bdash/kicad-components/3D Models/Molex_Micro-Fit_3.0_43045-0810_2x04-1MP_P3.00mm_Horizontal.stp

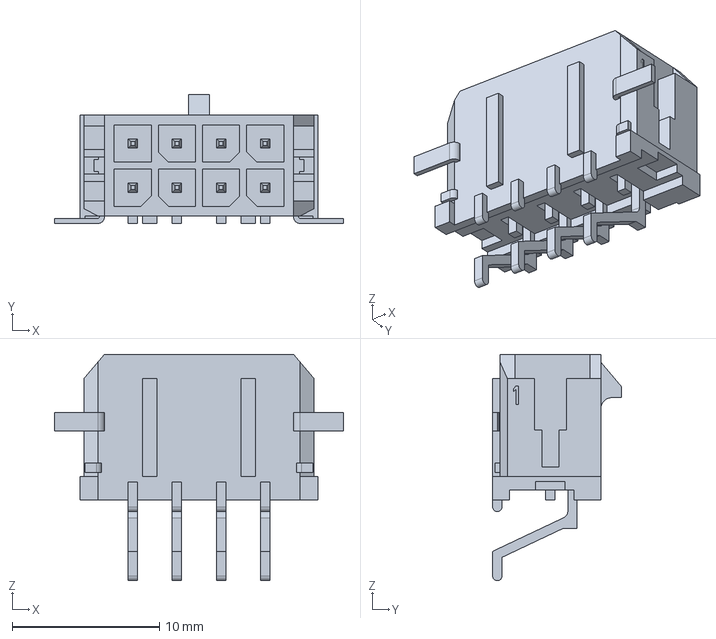
[picture p1: CAD file, 2024-04-28]
3D Models/Molex_Micro-Fit_3.0_43045-0810_2x04-1MP_P3.00mm_Horizontal.stp
19.6 x 8.77 x 15.4 mm
