bdash/kicad-components/3D Models/Molex_Micro-Fit_3.0_43045-1210_2x06-1MP_P3.00mm_Horizontal.stp

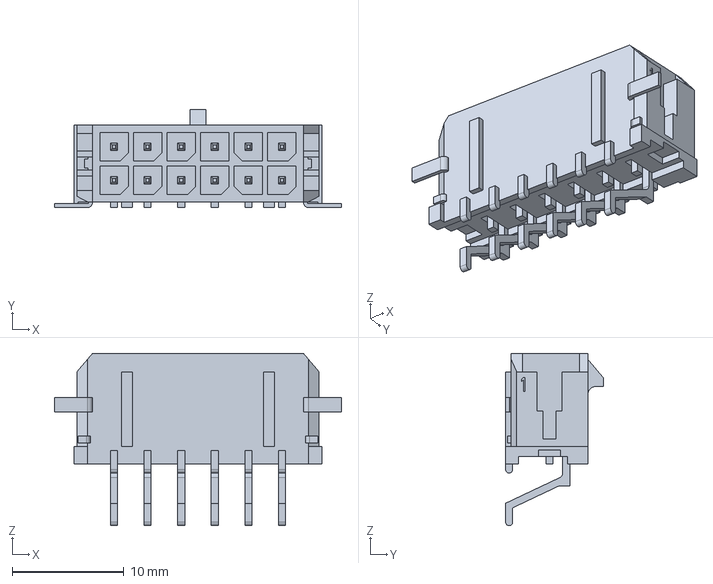
[picture p2: CAD file, 2024-04-28]
3D Models/Molex_Micro-Fit_3.0_43045-1210_2x06-1MP_P3.00mm_Horizontal.stp
25.6 x 8.77 x 15.4 mm
