bdash/kicad-components/3D Models/Molex_Micro-Fit_3.0_43650-0812_1x08-1MP_P3.00mm_Horizontal_PnP.stp

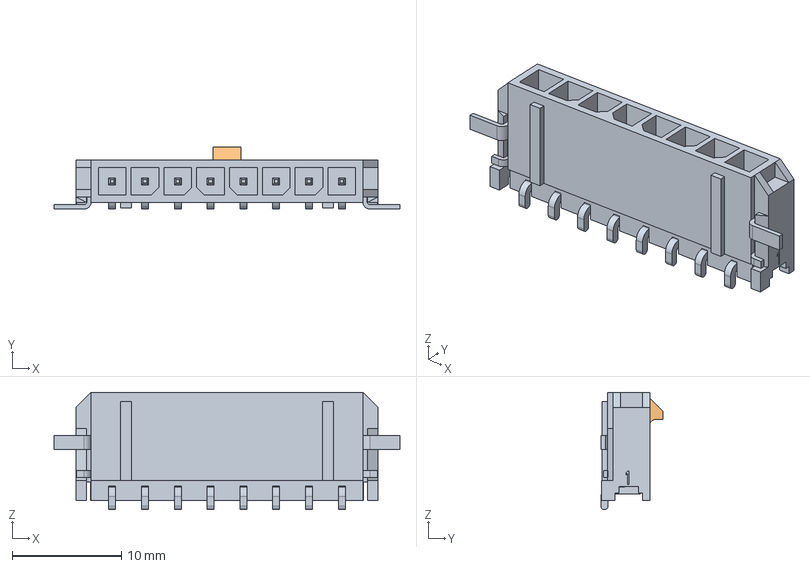
[picture p5: CAD file, 2024-04-14]
3D Models/Molex_Micro-Fit_3.0_43650-0812_1x08-1MP_P3.00mm_Horizontal_PnP.stp
31.6 x 5.67 x 10.7 mm
