bdash/kicad-components/3D Models/JST_PA_SM12B-PASS_1x12-1MP_P2.00mm_Horizontal.stp

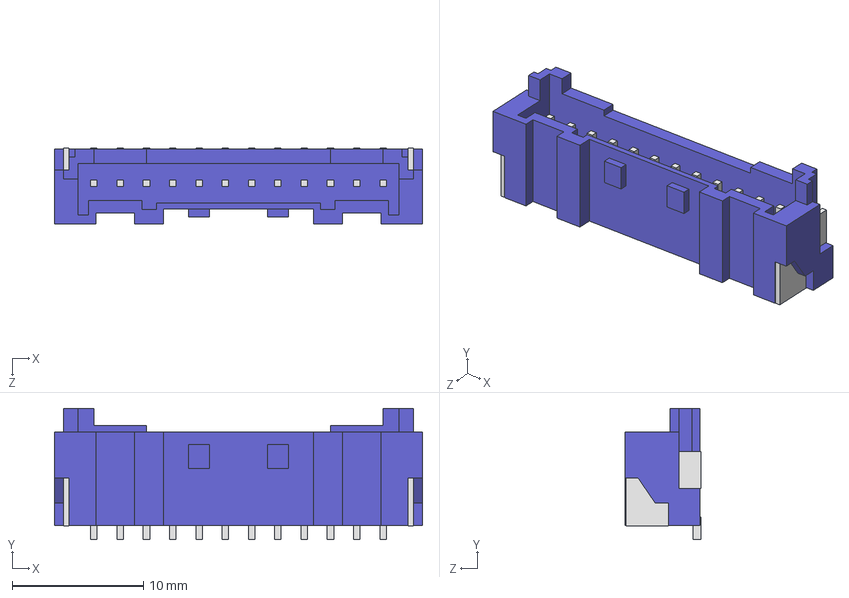
[picture p6: CAD file, 2024-04-14]
3D Models/JST_PA_SM12B-PASS_1x12-1MP_P2.00mm_Horizontal.stp
28.0 x 10.0 x 5.80 mm
