bdash/kicad-components/3D Models/JST_PA_SM09B-PASS_1x09-1MP_P2.00mm_Horizontal.stp

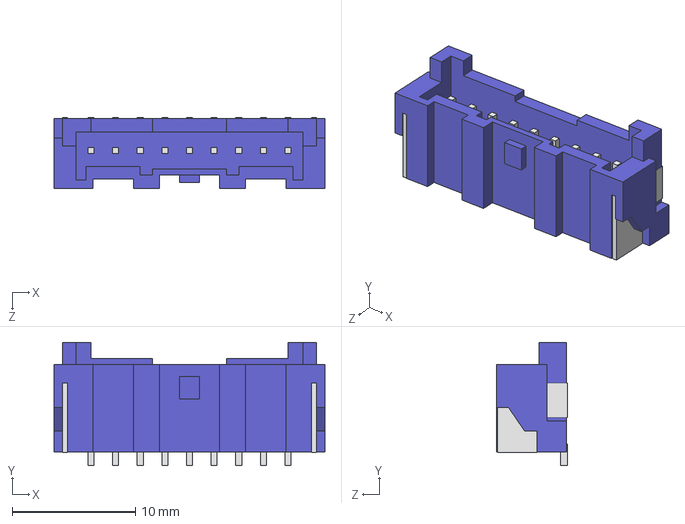
[picture p7: CAD file, 2024-04-14]
3D Models/JST_PA_SM09B-PASS_1x09-1MP_P2.00mm_Horizontal.stp
22.0 x 10.0 x 5.80 mm
