bdash/kicad-components/3D Models/Molex_Micro-Fit_3.0_43650-0912_1x09-1MP_P3.00mm_Horizontal_PnP.stp

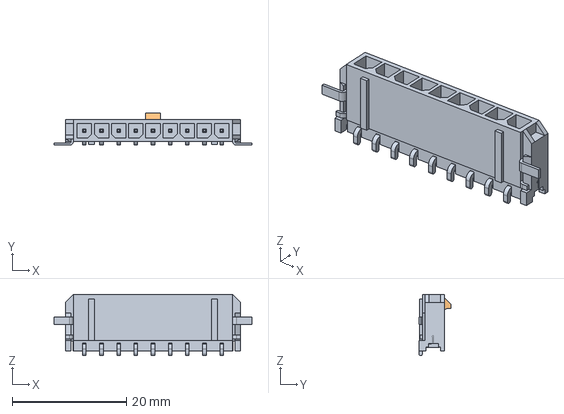
[picture p8: CAD file, 2024-04-12]
3D Models/Molex_Micro-Fit_3.0_43650-0912_1x09-1MP_P3.00mm_Horizontal_PnP.stp
34.6 x 5.67 x 10.7 mm
