bdash/kicad-components/3D Models/Lumileds LUXEON 2835 L128-3080003500000.stp

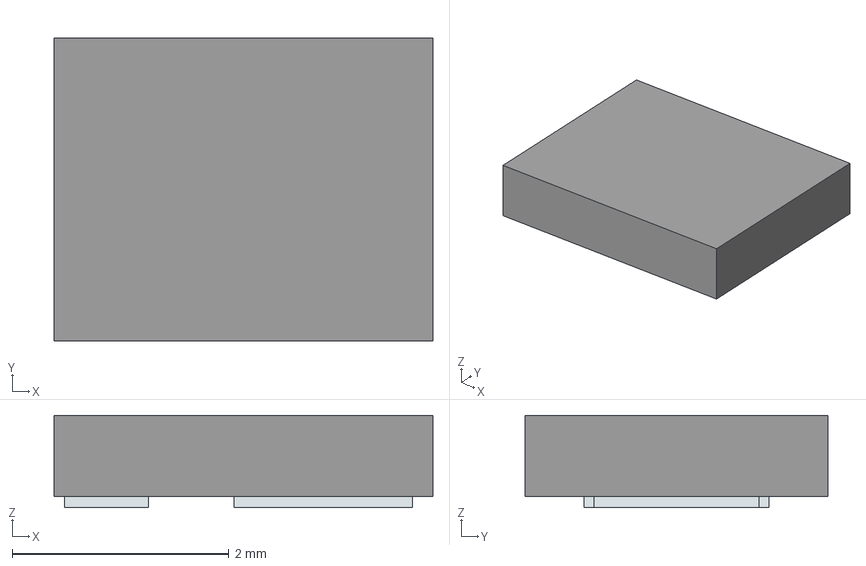
[picture p9: CAD file, 2024-04-12]
3D Models/Lumileds LUXEON 2835 L128-3080003500000.stp
3.50 x 2.80 x 0.85 mm
Pins
