bdash/kicad-components/3D Models/BU2450SM-JJ-GTR.step

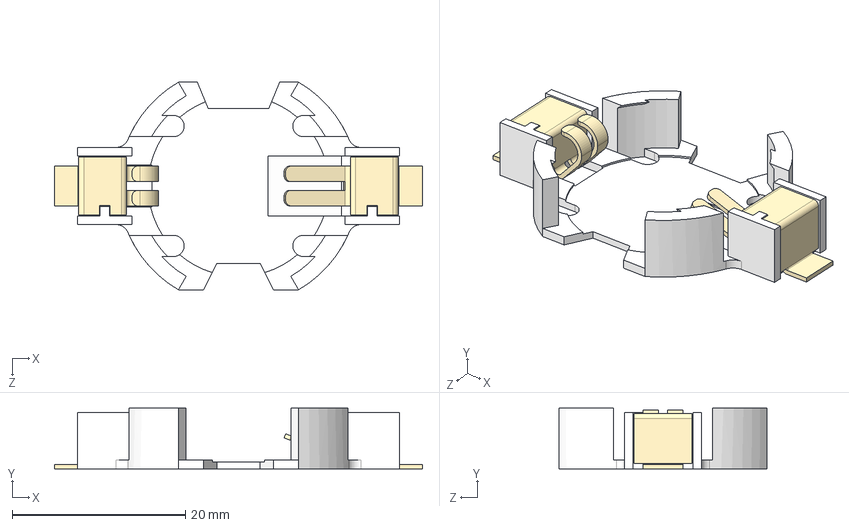
[picture p11: CAD file, 2024-01-24]
3D Models/BU2450SM-JJ-GTR.step
42.5 x 7.00 x 24.0 mm
