bdash/kicad-components/3D Models/IND_IHLP-4040DZ_VIS.step

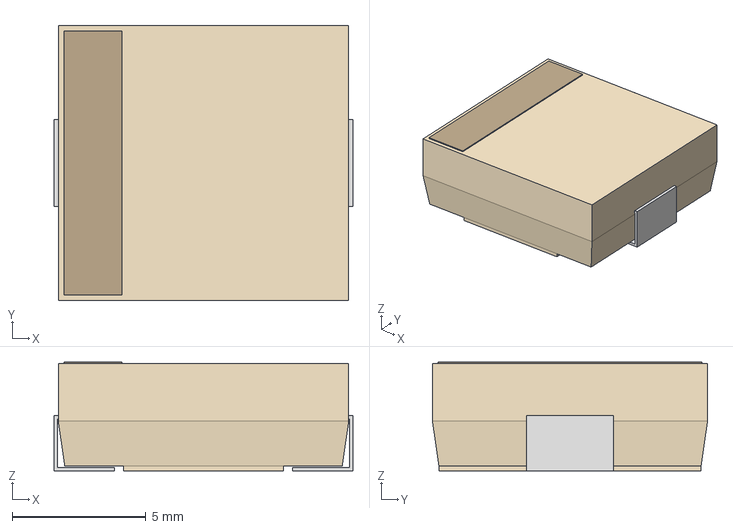
[picture p12: CAD file, 2023-09-18]
3D Models/IND_IHLP-4040DZ_VIS.step
11.2 x 10.3 x 4.06 mm
