bdash/kicad-components/3D Models/EA DOGS164W-A.step

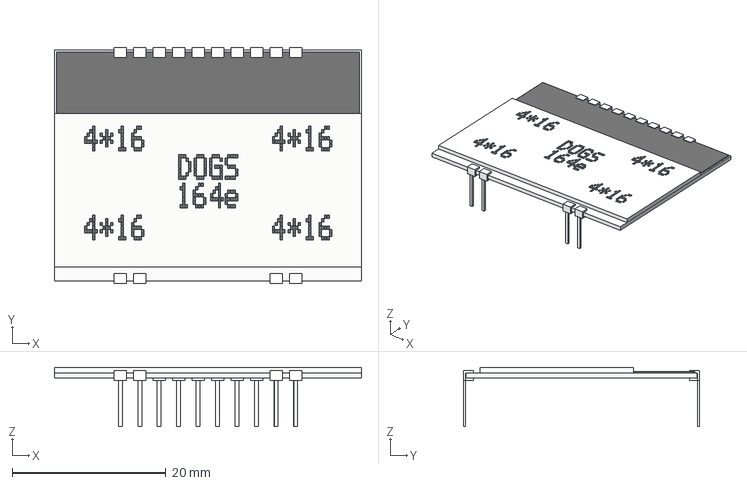
[picture p13: CAD file, 2023-09-08]
3D Models/EA DOGS164W-A.step
40.0 x 30.8 x 7.71 mm
