bdash/kicad-components/3D Models/1719710005.stp

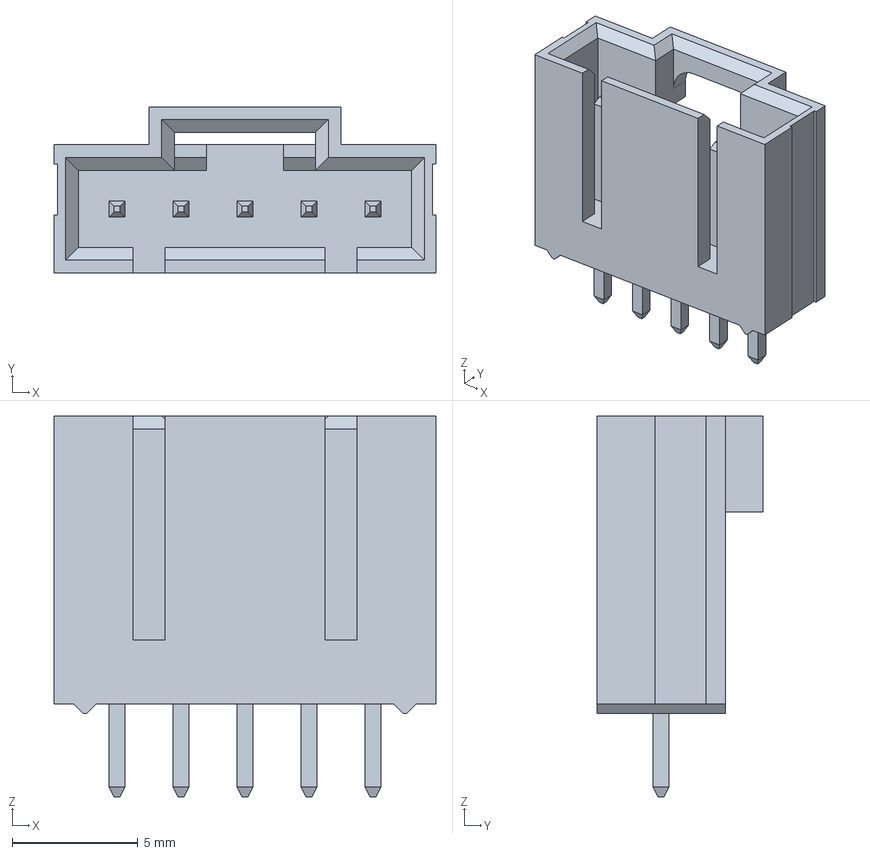
[picture p14: CAD file, 2024-01-24]
3D Models/1719710005.stp
15.2 x 6.60 x 15.1 mm
