bdash/kicad-components/3D Models/TPS563300DRLR.step

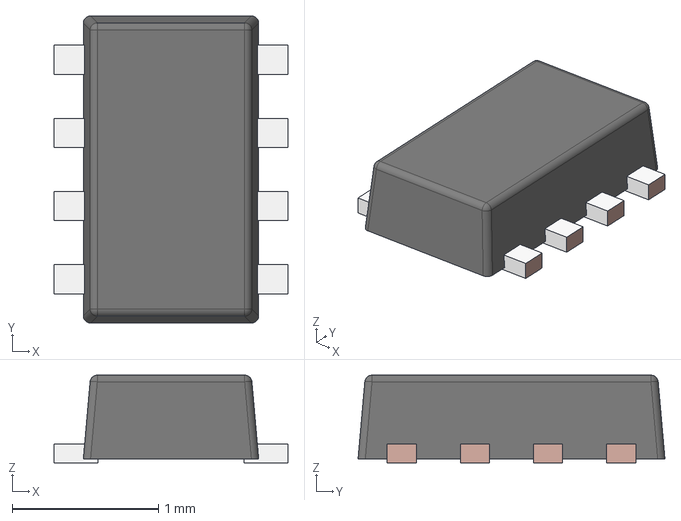
[picture p15: CAD file, 2023-09-18]
3D Models/TPS563300DRLR.step
1.60 x 2.10 x 0.6 mm
FRAME-DRL0008A
BODY-SOT
