bdash/kicad-components/(commit log)

2023-09-08 Bring in components from Williams System 9 display board
    [EA DOGS164W-A.step]
2023-09-08 LM66100: Add an alternate pin assignment for ST to silence ERC warning about it being tied to ground
2023-09-18 Add symbols, footprints, and models used in my earlier TPS563300 buck converter board
    [IND_IHLP-4040DZ_VIS.step, TPS563300DRLR.step]
2023-09-18 Allow missing solder mask between pads on TPS563300 due to fine pad pitch
2023-09-18 Add my own variant of L_Vishay_IHLP-4040 that references the 3D model
    This should hopefully silence some DRC checks about footprints not matching their library copies.
2024-01-24 Add footprints for WPC-S battery board
    [1719710005.stp, BU2450SM-JJ-GTR.step]
2024-04-12 Add Lumileds LUXEON 2835 LEDs and some Molex Micro-Fit 3.0 connectors
    [Lumileds LUXEON 2835 L128-3080003500000.stp, Molex_Micro-Fit_3.0_43650-0912_1x09-1MP_P3.00mm_Horizontal_PnP.stp, Molex_Micro-Fit_3.0_43650-1112_1x11-1MP_P3.00mm_Horizontal_PnP.stp]
2024-04-12 Add a mounting hole with clearance for a #6 screw.
2024-04-12 Fix symbol description so KiCad stops complaining about it
2024-04-14 Add footprints and models for some JST-PA right-angle SMT connectors
    [JST_PA_SM08B-PASS_1x08-1MP_P2.00mm_Horizontal.stp, JST_PA_SM09B-PASS_1x09-1MP_P2.00mm_Horizontal.stp, JST_PA_SM12B-PASS_1x12-1MP_P2.00mm_Horizontal.stp, Molex_Micro-Fit_3.0_43650-0812_1x08-1MP_P3.00mm_Horizontal_PnP.stp]
2024-04-28 Add 2x Molex Micro-Fit 3.0 connectors
    [Molex_Micro-Fit_3.0_43045-0810_2x04-1MP_P3.00mm_Horizontal.stp, Molex_Micro-Fit_3.0_43045-1010_2x05-1MP_P3.00mm_Horizontal.stp, Molex_Micro-Fit_3.0_43045-1210_2x06-1MP_P3.00mm_Horizontal.stp]
2026-09-26 Update to KiCad 10 format
